GewoonMaarten/fan-controller/schematic/fan_controller.pdf

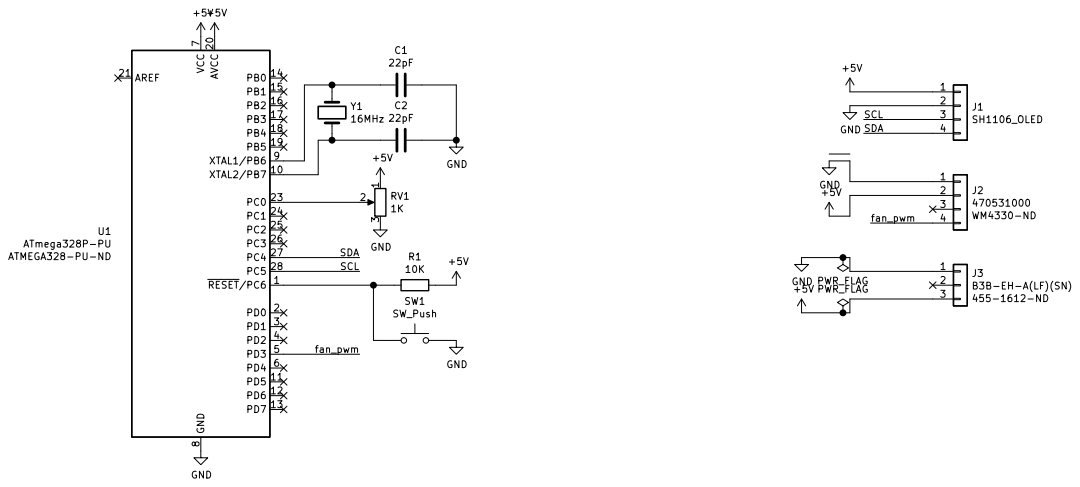
[picture p4: page 1]

File: fan_controller.sch Sheet: /
Id: 1/1 Title: Fan controller Cetus3D
