GewoonMaarten/fan-controller/schematic/fan_controller.kicad_pcb

## KiCad design schematic/fan_controller.kicad_pcb (2020-07-25)

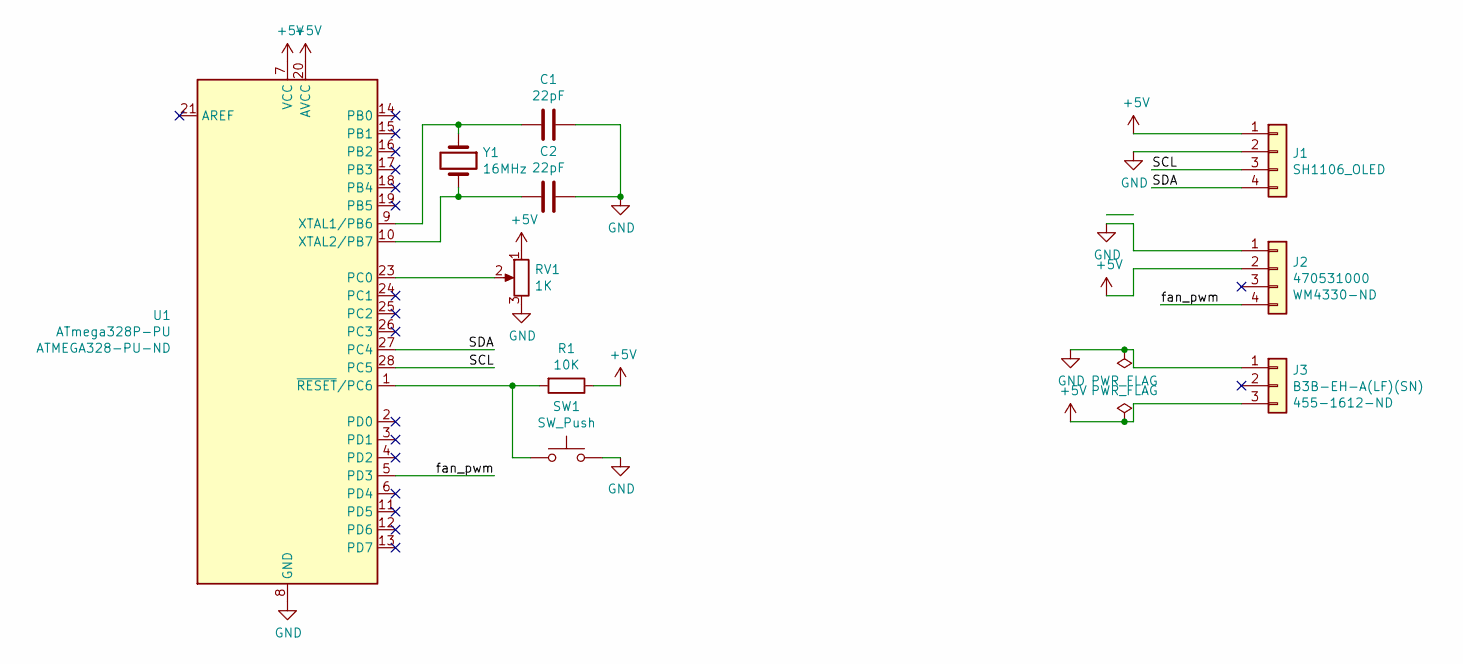
[picture p5: schematic fan_controller.sch, Fan controller Cetus3D]

Parts:
C1, C2: 22pF; C_Disc_D5.0mm_W2.5mm_P5.00mm
J1: SH1106_OLED; PinHeader_1x04_P2.54mm_Horizontal
J2: 470531000; digikey WM4330-ND
J3: B3B-EH-A(LF)(SN); JST_EH_B3B-EH-A_1x03_P2.50mm_Vertical
R1: 10K; R_Axial_DIN0207_L6.3mm_D2.5mm_P7.62mm_Horizontal
RV1: 1K; Potentiometer_Piher_T-16H_Single_Horizontal
SW1: SW_Push; SW_PUSH_6mm
U1: ATmega328P-PU; DIP-28_W7.62mm; digikey ATMEGA328-PU-ND
Y1: 16MHz; Crystal_HC49-4H_Vertical

Connections:
+5V: J1.1, J2.2, J3.3, R1.1, RV1.1, U1.7 (VCC), U1.20 (AVCC)
/SCL: J1.3, U1.28 (PC5)
/SDA: J1.4, U1.27 (PC4)
/fan_pwm: J2.4, U1.5 (PD3)
GND: C1.1, C2.1, J1.2, J2.1, J3.1, RV1.3, SW1.2, U1.8 (GND), U1.22 (GND)
unnamed: C1.2, U1.9 (XTAL1/PB6), Y1.1
unnamed: C2.2, U1.10 (XTAL2/PB7), Y1.2
unnamed: R1.2, SW1.1, U1.1 (~RESET~/PC6)
unnamed: RV1.2, U1.23 (PC0)

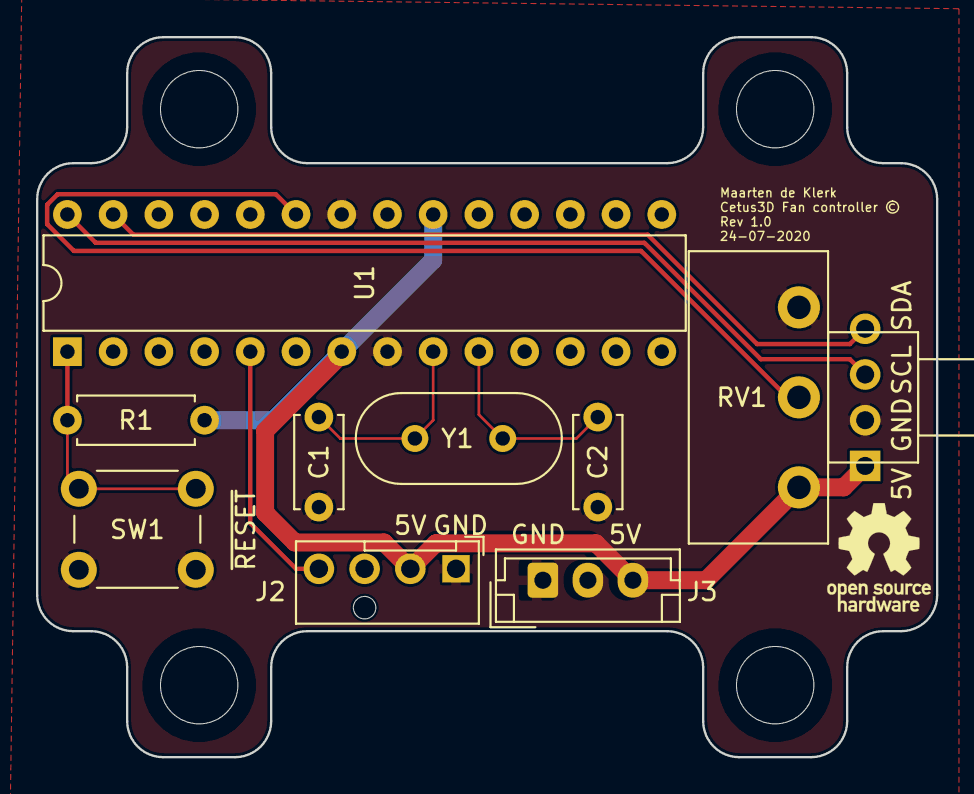
[picture p6: board fan_controller.kicad_pcb from above]

Board: 2 copper layers, 50.0 x 40.0 mm, 10 parts (1 on the bottom side), 9 nets.
