GewoonMaarten/fan-controller/pwm_fan_controller/images.h

#define fan_icon_width 32
#define fan_icon_height 32

const unsigned char PROGMEM fan_icon_bmp [] = {
0x00, 0x00, 0x00, 0x00, 0x00, 0x00, 0x00, 0x00, 0x00, 0x03, 0x80, 0x00, 0x00, 0x1F, 0xF8, 0x00,
0x00, 0x7F, 0xFE, 0x00, 0x01, 0xFF, 0xFF, 0x00, 0x03, 0xE0, 0x07, 0xC0, 0x07, 0xC0, 0x03, 0xC0,
0x07, 0x8F, 0x01, 0xE0, 0x0F, 0x1F, 0x00, 0xF0, 0x0E, 0x1F, 0x80, 0x70, 0x1C, 0x1F, 0x80, 0x38,
0x1C, 0x1F, 0x80, 0x38, 0x1C, 0x0F, 0x80, 0x38, 0x1C, 0x00, 0x0E, 0x38, 0x3C, 0x01, 0xBF, 0x3C,
0x3C, 0x0D, 0xBF, 0x3C, 0x1C, 0x3C, 0x3F, 0xB8, 0x1C, 0x3E, 0x7F, 0x38, 0x1C, 0x7E, 0x3E, 0x38,
0x1C, 0x7E, 0x00, 0x78, 0x0E, 0x3E, 0x00, 0x70, 0x0F, 0x3C, 0x00, 0xF0, 0x07, 0x80, 0x01, 0xE0,
0x03, 0xC0, 0x03, 0xC0, 0x03, 0xF0, 0x0F, 0xC0, 0x00, 0xFF, 0xFF, 0x00, 0x00, 0x7F, 0xFE, 0x00,
0x00, 0x1F, 0xF8, 0x00, 0x00, 0x01, 0x80, 0x00, 0x00, 0x00, 0x00, 0x00, 0x00, 0x00, 0x00, 0x00
};
