GewoonMaarten/fan-controller/(commit log)

2020-07-25 Added schematic as pdf
2020-07-30 Updated schematic
    [fan_controller.sch]
